Jrgordon04/over-terrain-vehicle-material/Assembled OTV.jpeg

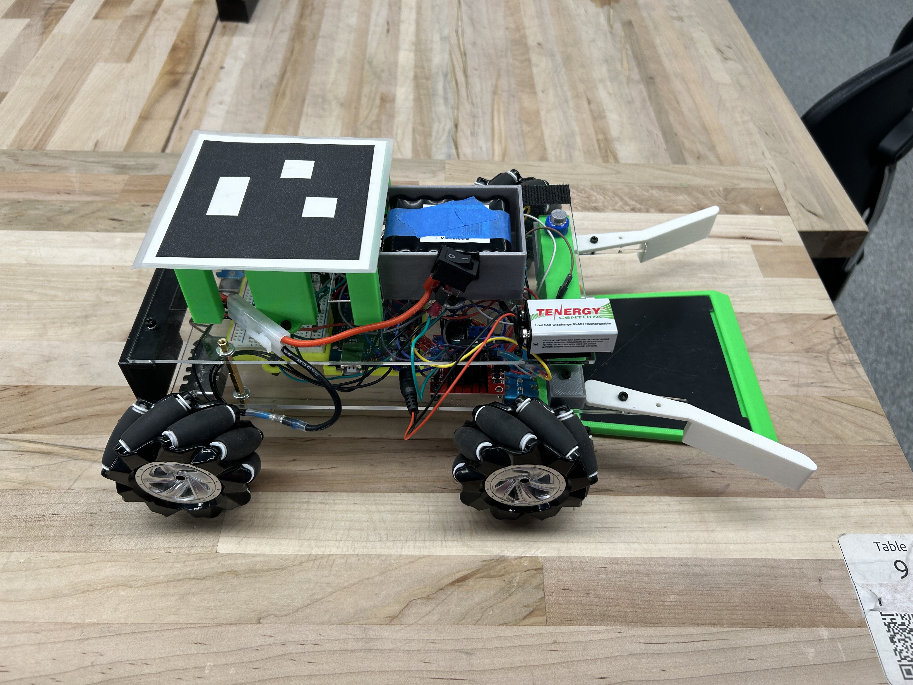
Assembled OTV.jpeg
